machintrucbidule/wordclock/Photos/20201205_142626.jpg

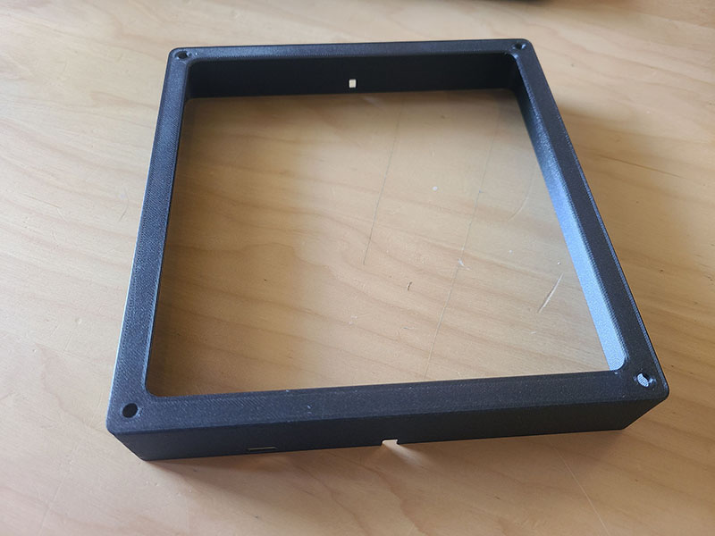
Photos/20201205_142626.jpg
