machintrucbidule/wordclock/Photos/20201205_142713.jpg

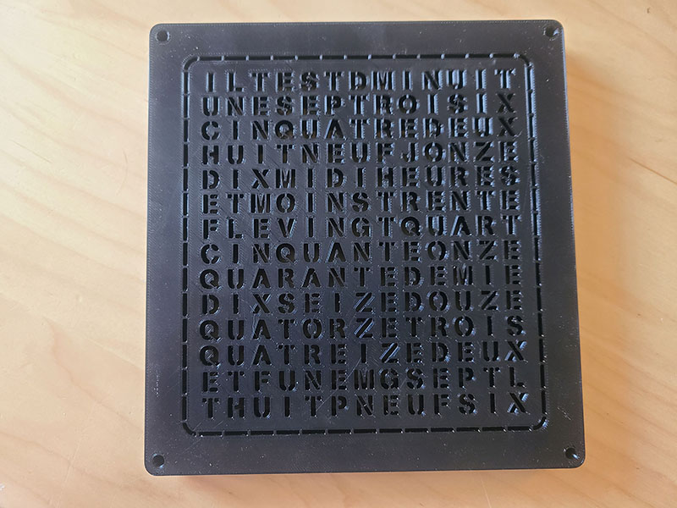
Photos/20201205_142713.jpg
