machintrucbidule/wordclock/Photos/20201205_143129.jpg

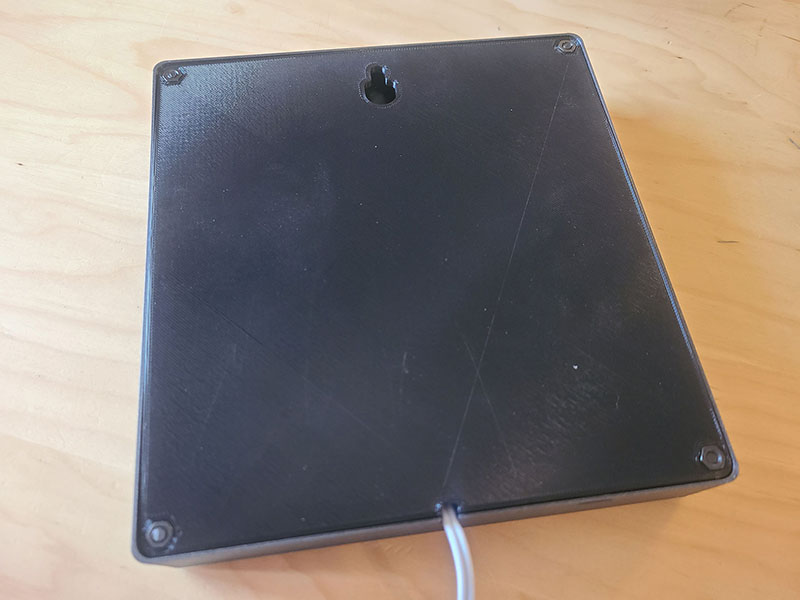
Photos/20201205_143129.jpg
