machintrucbidule/wordclock/Photos/20201205_143147.jpg

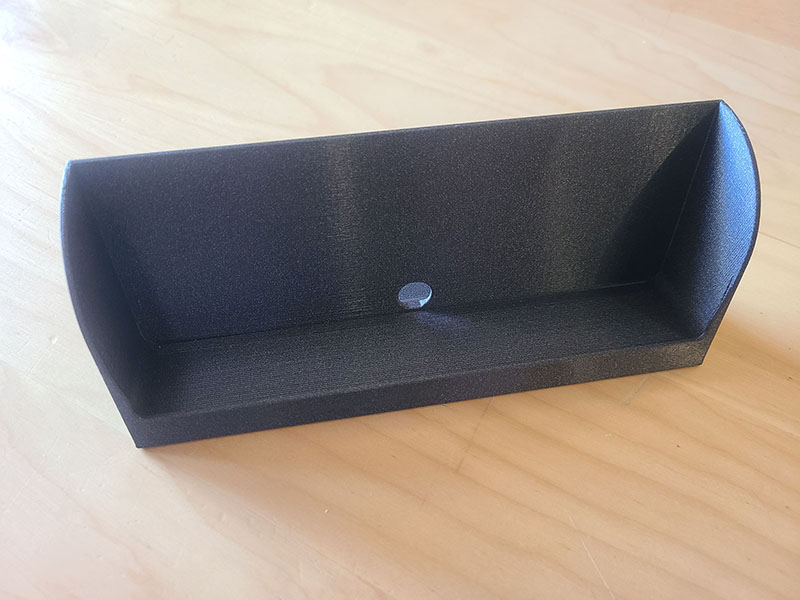
Photos/20201205_143147.jpg
