machintrucbidule/wordclock/Photos/20201205_143304.jpg

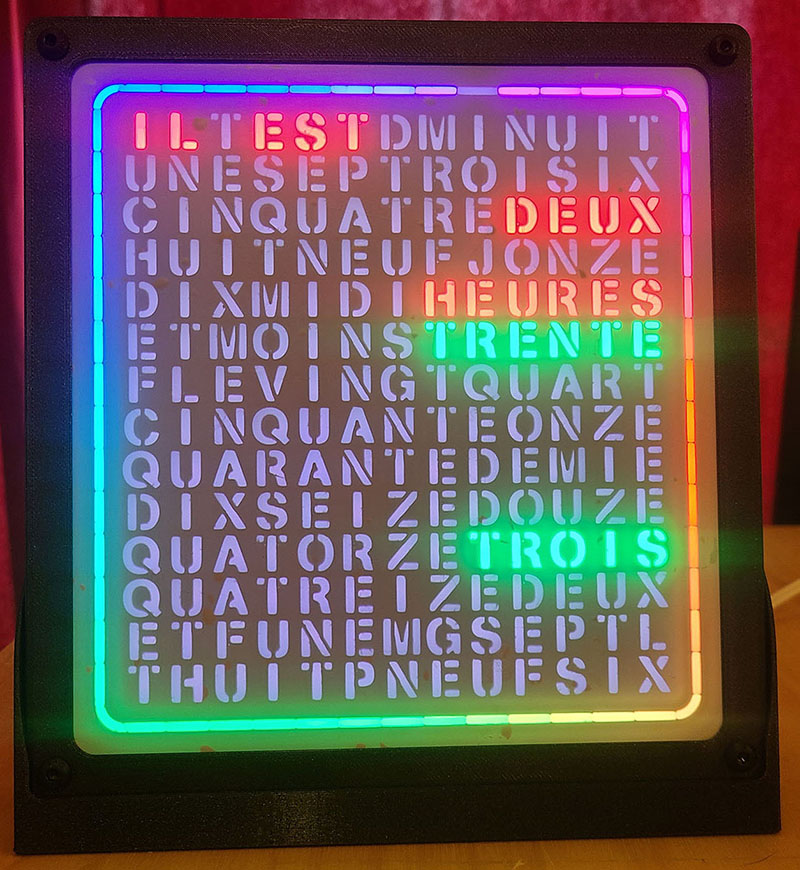
Photos/20201205_143304.jpg
