machintrucbidule/wordclock/Photos/config/config_1.jpg

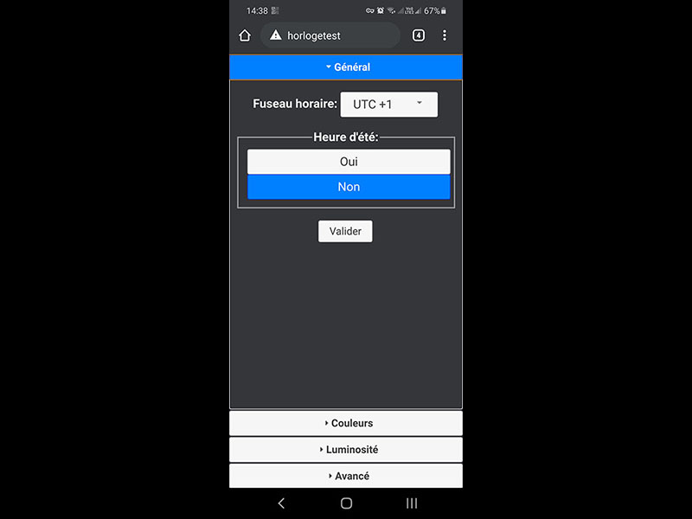
Photos/config/config_1.jpg
