machintrucbidule/wordclock/Photos/config/config_2.jpg

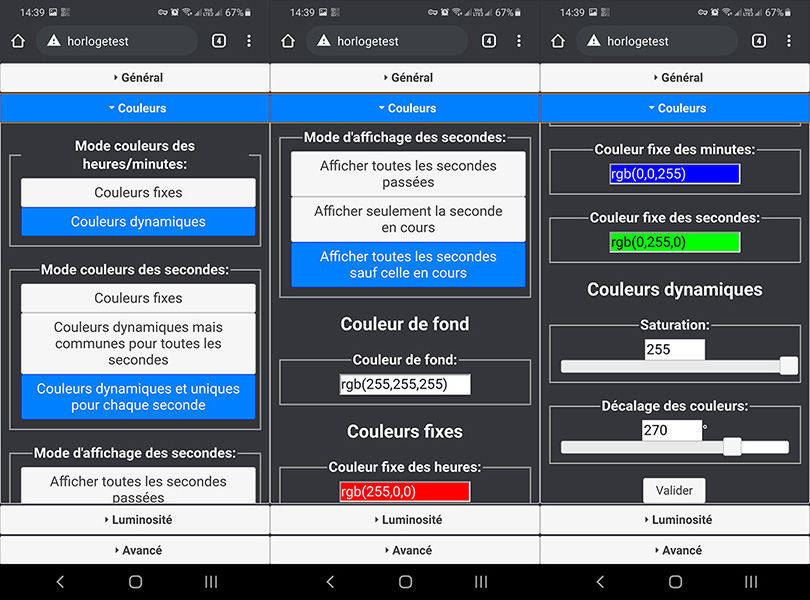
Photos/config/config_2.jpg
