machintrucbidule/wordclock/Photos/config/config_3.jpg

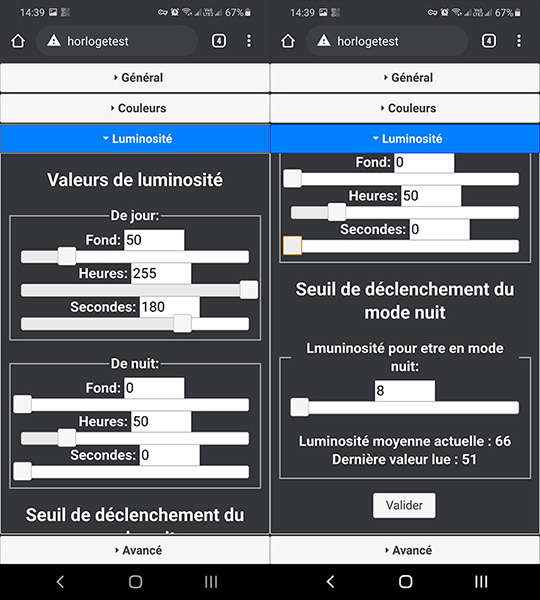
Photos/config/config_3.jpg
