machintrucbidule/wordclock/Photos/config/config_4.jpg

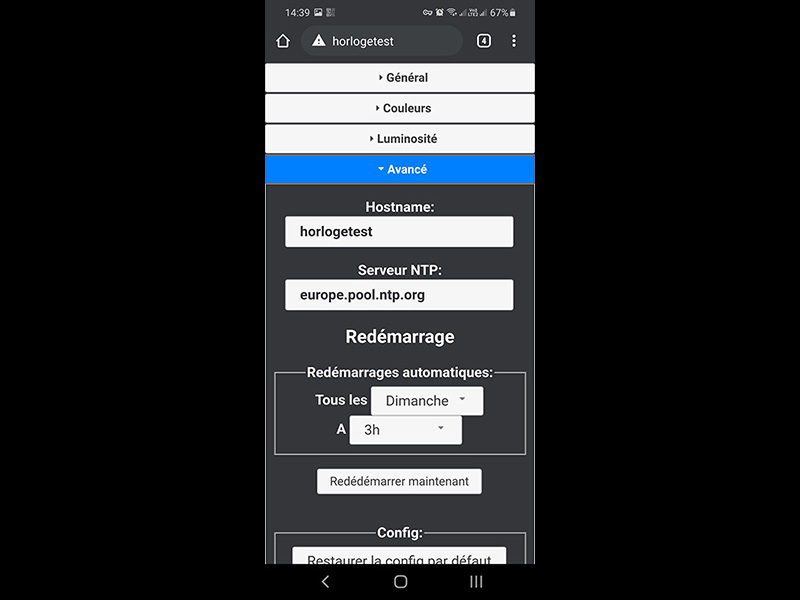
Photos/config/config_4.jpg
