machintrucbidule/wordclock/Photos/config/Screenshot_20201205-143856_Chrome.jpg

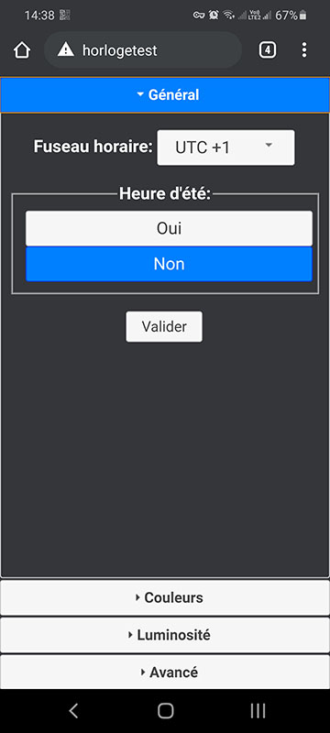
Photos/config/Screenshot_20201205-143856_Chrome.jpg
