machintrucbidule/wordclock/Photos/config/Screenshot_20201205-143909_Chrome.jpg

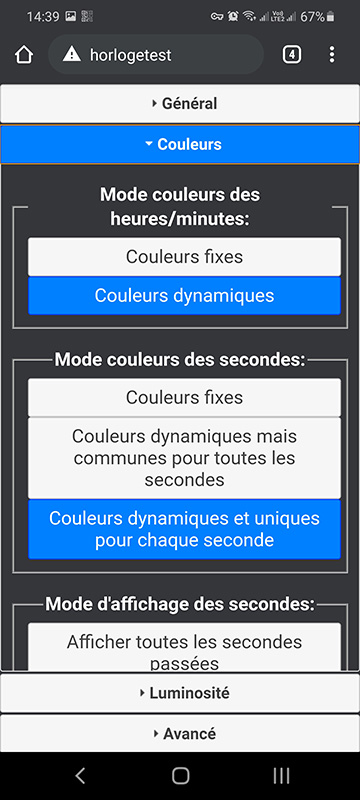
Photos/config/Screenshot_20201205-143909_Chrome.jpg
