machintrucbidule/wordclock/Photos/config/Screenshot_20201205-143914_Chrome.jpg

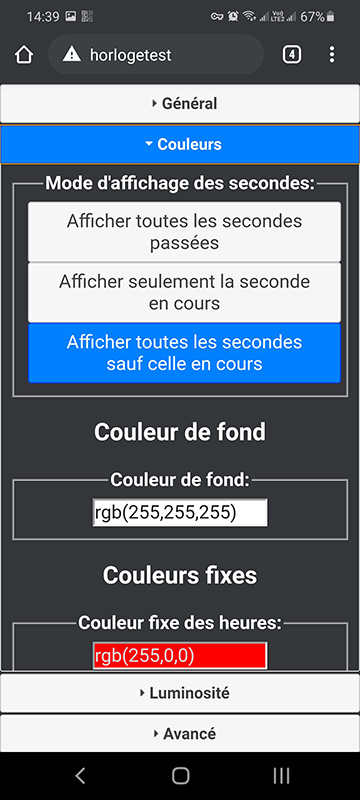
Photos/config/Screenshot_20201205-143914_Chrome.jpg
