machintrucbidule/wordclock/Photos/config/Screenshot_20201205-143920_Chrome.jpg

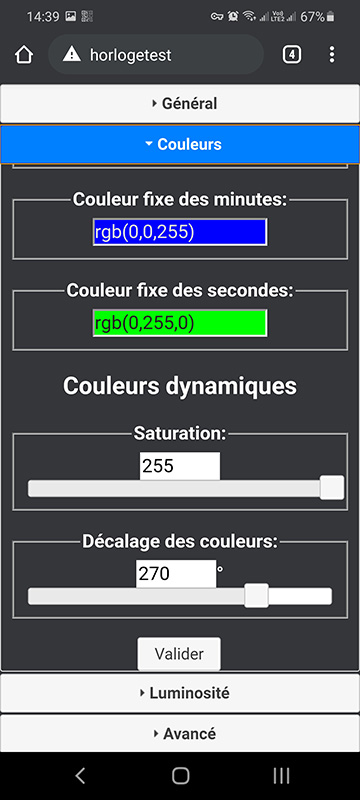
Photos/config/Screenshot_20201205-143920_Chrome.jpg
