machintrucbidule/wordclock/Photos/config/Screenshot_20201205-143925_Chrome.jpg

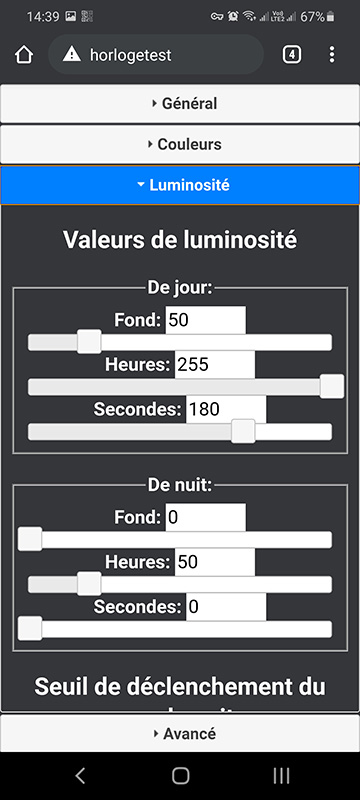
Photos/config/Screenshot_20201205-143925_Chrome.jpg
