machintrucbidule/wordclock/Photos/config/Screenshot_20201205-143944_Chrome.jpg

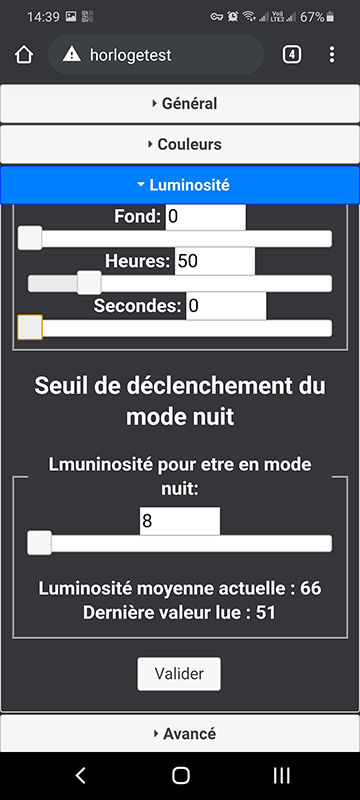
Photos/config/Screenshot_20201205-143944_Chrome.jpg
