machintrucbidule/wordclock/(threads)

Thread 1 (2022-02-28):

WIFI connection

floriank1976, 2022-02-28:
Hello, first of all, great Project, thanks a lot for sharing!

I have a problem connecting to my Wifi (WPA2 CCMP).
When i create a Hotpot with my phone, it works, but not with my router.
Have you already heard about this problem?

Thanks in advance
Florian

icalmels, 2022-02-28:
Hi,

You mean that you're not able to connect on your routeur from the ESP8266, right?

First, you should try closer to your router (ESP8266 aren't powerfull and are quiete impacted by interferences).
Then you should check that your router is having separate 5Ghz and 2.4Ghz wifi networks. Indeed, ESP8266 is only able to connect on 2.4Ghz. On my router ("livebox" from Orange, my ISP), by default 5 and 2.4Ghz network are some kind of "merged" and that's not working with ESP8266. But with both network, and configuring ESP on the 2.4 one that's working fine.

And if still not working, I would advise to ask on a board dedicated to ESP8266 (there
for instance : https://github.com/esp8266/Arduino)

Regards,
Ivan

floriank1976, 2022-03-08:
Hi, thanks for your help!
The problem was the force B network. My router was set to only use GN.

BR
Florian

Closed 2023-10-21.

Thread 2 (2023-10-21):

IP Adress and other troubles

Sorcerer34, 2023-10-21:
Good morning.
I am trying to complete the configuration of my clock but the HTTP server is in the address range 192.168.4.1
which does not correspond to my network address.
To avoid causing panic in my installation, it would be more practical for me if the clock was located in the 192.168.1.x
address area but I have not yet found where this parameter can be modified.
A helping hand please???

Furthermore, I have not modified the code downloaded from the gitub, but I only have 15 LEDs that light up in width
(compared to 16 in height) and I fear that this will cause me problems when my configuration is completed .
What did I miss??

Thank you very much for any help.
Serge

machintrucbidule, 2023-10-21:
Hi Serge,

The issue isn't on the code side, but on your router. That's your router which is defining the ip address, not the clock.
(My router is also on the 192.168.1.x range, and all is working fine - and it would also work by default with a 10.0.0.x, 192.168.4.x range ... or anything else).

For the 15 width LED that's perfectly normal, no issue here. The letters matrix requires 13x14 leds. By adding the borders for seconds (top, right, bottom, left) it ends with a 15x16 matrix. One column isn't used, but as 15x16 led matrix aren't exising, I used a 16x16 one, with one column of leds kept blank.

Sorcerer34, 2023-10-21:
Good evening machintrucbidule...

I perfectly understood your explanation regarding the space of 15x16 LEDs needed for the display. We can also count on one of the images of the Github and we can see very clearly that in width there are only 15 LEDs lit. My mistake.

On the other hand, I don't quite understand your explanation regarding the router and IP addresses.
My router is in the 192.168.1.xx address range and I don't understand how the clock retrieves a 192.168.4.1 address?
Attached is an extract from the serial monitor:

"15:51:12.859 -> *wm:StartAP with SSID: clock
15:51:13.985 -> *wm:AP IP address: 192.168.4.1
15:51:13.985 -> Unable to connect on wifi - Entered wifi config mode
15:51:13.985 --> 192.168.4.1
15:51:13.985 -> clock
15:51:13.985 -> Display orange ring while wifi configuration
15:51:13.985 -> *wm:Starting Web Portal
"
I just re-checked my router configuration, there is no mention of the address range 192.168.4.xx
The sketch takes it from somewhere this address????
I must be missing something there...

Thank you so much.

machintrucbidule, 2023-10-21:
Ah, that's the first startup, when not yet connected on the wifi
Here the clock is seting up a new wifi network named "horloge". You have to connect on it (easier with a smartphone), then it will redirect you to the "web portal" where you'll be able to select you wifi network and enter credentials.
From here clock will restart, connect on your home wifi network, and will get an ip address from your router.
You also have a quick explanation on the "§6 Usage" of the readme.

That's the behaviour of the library "WiFiManager", which I used to be able to connect on any wifi network without having to change any configuration file. I can't change anything about it, but from my point of view that's working great as is (as soon you understand it creates a new wifi network 😁)

Sorcerer34, 2023-10-21:
Great great great .....
With the right method, it works better.
That's it, the configuration is complete and the clock displays the time.
Once again, thank you.
Friendships
Serge

machintrucbidule, 2023-10-21:
Welcome !

And now (if not already figured out) if you want to reach clock's configuration, you have to retrieve its ip address on your network (or on serial monitor) and put it on any web browser connected on the same network

machintrucbidule, 2023-10-21:
And by the way, I just pushed an update on the "functions.ino" file, for an old fix on color managment on a few situations, and which I had not committed

machintrucbidule, 2023-10-21:
And I close the issue

Closed 2023-10-21.

Thread 3 (2024-01-05):

Adding USB-C port

whomble, 2024-01-05:
Hi! I want to replace the cable by an usb-c port, it should'nt consume more than 3A at 5V so could you upload the original files?
I also want to decrease the overall thickness to consume less filament and change some dimensions to make it fit on a A1mini.

machintrucbidule, 2024-01-05:
Hi,

I just put the Fusion360's F3D file on printables : https://www.printables.com/model/425721-word-clock-french/files

Closed 2024-01-05.
