machintrucbidule/wordclock/src/horloge/ledarrays.ino

//Initialization of the ids
void initLedsArrays(){
  //start
  ledsarray_start["il"] =       {17,18};
  ledsarray_start["est"] =      {20,21,22};

  //hours
  ledsarray_hours["minuit"] =   {24,25,26,27,28,29};
  ledsarray_hours["1"] =        {44,45,46};
  ledsarray_hours["7"] =        {40,41,42,43};
  ledsarray_hours["3"] =        {36,37,38,39,40};
  ledsarray_hours["6"] =        {34,35,36};
  ledsarray_hours["5"] =        {49,50,51,52};
  ledsarray_hours["4"] =        {52,53,54,55,56,57};
  ledsarray_hours["2"] =        {58,59,60,61};
  ledsarray_hours["8"] =        {75,76,77,78};
  ledsarray_hours["9"] =        {71,72,73,74};
  ledsarray_hours["11"] =       {66,67,68,69};
  ledsarray_hours["10"] =       {81,82,83};
  ledsarray_hours["midi"] =     {84,85,86,87};
  ledsarray_hours["heure"] =    {88,89,90,91,92};
  ledsarray_hours["s"] =        {93};
  
  ledsarray_minutes["et"] =     {109,110};
  ledsarray_minutes["moins"] =  {104,105,106,107,108};
  ledsarray_minutes["30"] =     {98,99,100,101,102,103};
  ledsarray_minutes["le"] =     {114,115};
  ledsarray_minutes["20"] =     {116,117,118,119,120};
  ledsarray_minutes["quart"] =  {121,122,123,124,125};
  ledsarray_minutes["5"] =      {139,140,141,142};
  ledsarray_minutes["50"] =     {134,135,136,137,138,139,140,141,142};
  ledsarray_minutes["11"] =     {130,131,132,133};
  ledsarray_minutes["40"] =     {145,146,147,148,149,150,151,152};
  ledsarray_minutes["demie"] =  {153,154,155,156,157};
  ledsarray_minutes["10"] =     {172,173,174};
  ledsarray_minutes["16"] =     {167,168,169,170,171};
  ledsarray_minutes["12"] =     {162,163,164,165,166};
  ledsarray_minutes["14"] =     {177,178,179,180,181,182,183,184};
  ledsarray_minutes["3"] =      {185,186,187,188,189};
  ledsarray_minutes["4"] =      {201,202,203,204,205,206};
  ledsarray_minutes["13"] =     {198,199,200,201,202,203};
  ledsarray_minutes["2"] =      {194,195,196,197};
  ledsarray_minutes["et_minutes"] =   {209,210};
  ledsarray_minutes["1"] =      {212,213,214};
  ledsarray_minutes["7"] =      {217,218,219,220};
  ledsarray_minutes["8"] =      {234,235,236,237};
  ledsarray_minutes["9"] =      {229,230,231,232};
  ledsarray_minutes["6"] =      {226,227,228};

  ledsarray_seconds["0"]   =      {};
  ledsarray_seconds["1"]   =      {8};
  ledsarray_seconds["2"]   =      {7};
  ledsarray_seconds["3"]   =      {6};
  ledsarray_seconds["4"]   =      {5};
  ledsarray_seconds["5"]   =      {4};
  ledsarray_seconds["6"]   =      {3};
  ledsarray_seconds["7"]   =      {2};
  ledsarray_seconds["8"]   =      {1};
  ledsarray_seconds["9"]   =      {30};
  ledsarray_seconds["10"]  =      {33};
  ledsarray_seconds["11"]  =      {62};
  ledsarray_seconds["12"]  =      {65};
  ledsarray_seconds["13"]  =      {94};
  ledsarray_seconds["14"]  =      {97};
  ledsarray_seconds["15"]  =      {126};
  ledsarray_seconds["16"]  =      {129};
  ledsarray_seconds["17"]  =      {158};
  ledsarray_seconds["18"]  =      {161};
  ledsarray_seconds["19"]  =      {190};
  ledsarray_seconds["20"]  =      {193};
  ledsarray_seconds["21"]  =      {222};
  ledsarray_seconds["22"]  =      {225};
  ledsarray_seconds["23"]  =      {254};
  ledsarray_seconds["24"]  =      {253};
  ledsarray_seconds["25"]  =      {252};
  ledsarray_seconds["26"]  =      {251};
  ledsarray_seconds["27"]  =      {250};
  ledsarray_seconds["28"]  =      {249};
  ledsarray_seconds["29"]  =      {248};
  ledsarray_seconds["30"]  =      {};     //58 available leds for the seconds, so nothing will be displayed for 30s
  ledsarray_seconds["31"]  =      {247};
  ledsarray_seconds["32"]  =      {246};
  ledsarray_seconds["33"]  =      {245};
  ledsarray_seconds["34"]  =      {244};
  ledsarray_seconds["35"]  =      {243};
  ledsarray_seconds["36"]  =      {242};
  ledsarray_seconds["37"]  =      {241};
  ledsarray_seconds["38"]  =      {240};
  ledsarray_seconds["39"]  =      {239};
  ledsarray_seconds["40"]  =      {208};
  ledsarray_seconds["41"]  =      {207};
  ledsarray_seconds["42"]  =      {176};
  ledsarray_seconds["43"]  =      {175};
  ledsarray_seconds["44"]  =      {144};
  ledsarray_seconds["45"]  =      {143};
  ledsarray_seconds["46"]  =      {112};
  ledsarray_seconds["47"]  =      {111};
  ledsarray_seconds["48"]  =      {80};
  ledsarray_seconds["49"]  =      {79};
  ledsarray_seconds["50"]  =      {48};
  ledsarray_seconds["51"]  =      {47};
  ledsarray_seconds["52"]  =      {16};
  ledsarray_seconds["53"]  =      {15};
  ledsarray_seconds["54"]  =      {14};
  ledsarray_seconds["55"]  =      {13};
  ledsarray_seconds["56"]  =      {12};
  ledsarray_seconds["57"]  =      {11};
  ledsarray_seconds["58"]  =      {10};
  ledsarray_seconds["59"]  =      {9};
}
