machintrucbidule/wordclock/(commit log)

2020-12-04 Updated readme file, moved code to an "horloge" folder as Arduino IDE needs to have the main folder with same name than main file.
2023-10-21 Add files via upload
    Fix an issue on color management
    [functions.ino]
